dbailey1564/marketsys-pen-routing/docs/three-node-flow-walkthrough.md

# Three-node controller advancement walkthrough

Updated November 4, 2026 for controller 0.6.2 and nodes 0.6.0. The host sends
only a destination for each simulated new head. The controller computes and
applies ACTIVE/LAST/HOLD_OPEN/OFF. The binary application interface and event
identity/replies remain deferred; this is a deliberate bench invocation per head.

| Step | Input/event | Node1 | Node2 | Node3 |
| --- | --- | --- | --- | --- |
| 0 | All OFF | OFF | OFF | OFF |
| 1 | Destination P1 | ACTIVE | OFF | OFF |
| 2 | Destination P2 | LAST | ACTIVE | OFF |
| 3 | Destination P3 | OFF | LAST | ACTIVE |
| 4 | Destination P3 (repeat, HOLD_OPEN) | OFF | OFF | HOLD_OPEN |
| 5 | Destination P2 | OFF | ACTIVE | LAST |
| 6 | Destination P1 | ACTIVE | LAST | OFF |
| 7 | Destination P3 | LAST | OFF | ACTIVE |
| 8 | Destination P2 | OFF | ACTIVE | LAST |
| 9 | Destination P2 (repeat, HOLD_OPEN) | OFF | HOLD_OPEN | OFF |
| 10 | Destination P1 | ACTIVE | LAST | OFF |
| 11 | Destination P1 (repeat, HOLD_OPEN) | HOLD_OPEN | OFF | OFF |
| 12 | Destination P2 | LAST | ACTIVE | OFF |
| 13 | Destination P3 | OFF | LAST | ACTIVE |
| 14 | Finish all OFF | OFF | OFF | OFF |

ACTIVE = solid green; LAST = solid blue; HOLD_OPEN = flashing green. Each row
holds until the user requests `next`. `start` initializes OFF and `stop` performs
explicit new-auction clearing. Manual mode waits for the next command. No light state is
sent by the host on a destination row. Live polls verify all three expected
states after each operation; the user supplies physical color/flashing confirmation.

On Lin, use the UART virtual-environment Python with `scripts/flow_walkthrough.py`
and action `plan`, `start`, `next`, `status` or `stop`. Local test progress is
saved under ignored build/. If delivery/polling fails, the host stops advancing.
Query `FLOW` to resolve an ambiguous result; do not repeat DEST as a retry.
Controller `FLOW=RETRY` resumes paused work, or use explicit new-auction clear.
FULL/FAULT remain outside normal advancement and are not generated by this test.
The prior manual-state walkthrough was prepared but never started; this version
is intended to validate actual controller-owned advancement after upload.

Current rule correction (November 4): HOLD_OPEN clears the previous LAST to OFF and clears its role. Each new head advances that history; blue is not reserved across repeats.

## Automatic demo

On Lin, from the project directory, run:

```sh
python3 scripts/flow_walkthrough.py auto --interval 15 --passes 4
```

Start on an idle bench system. The runner clears the auction at the start of the demo and
at the end of every pass. Each verified
row is held for 15 seconds before issuing the next destination or clear. Four
passes take at least fourteen minutes, plus radio verification. No operator input
is needed between rows. The runner stops if delivery or live polling fails.
After an interruption or failure, use `python3 scripts/flow_walkthrough.py stop`
to request and verify OFF.
