dbailey1564/marketsys-pen-routing/docs/interface-protocol-specification.md

# MarketSys Interface Protocol Specification

Review proposal — October 24, 2026. This document defines the proposed
app-to-controller interface. Firmware does not yet implement this host protocol.
The application assigns a new session ID for each auction and progressive transaction IDs per head within that session. The
CRC procedure below is exact for the current draft; changing frame fields
requires regenerating the frame examples, not changing the CRC algorithm.

## 1. Application boundary

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

## 2. Fixed-size outgoing HEAD_DESTINATION frame

With the proposed session and transaction fields, the outgoing
HEAD_DESTINATION frame is 16 bytes:

| Zero-based offset | COBOL position | Size | Field | Current draft |
| --- | --- | --- | --- | --- |
| 0-1 | 1-2 | 2 | SYNC | AA 55 |
| 2 | 3 | 1 | VERSION | 02 |
| 3 | 4 | 1 | TYPE | 10 = HEAD_DESTINATION |
| 4-7 | 5-8 | 4 | SESSION_ID | New ID for each auction |
| 8-11 | 9-12 | 4 | TRANSACTION_ID | Increasing per-head event number within the auction |
| 12 | 13 | 1 | DESTINATION_NUMBER | Numeric pen number, up to 255 |
| 13 | 14 | 1 | ALPHA_DESIGNATION | Reserved for letter designation |
| 14-15 | 15-16 | 2 | CRC16 | Low byte, then high byte |

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

Session/transaction integers use little-endian byte order in this draft.
If the engineer selects another event-identity structure, update offsets,
frame length and CRC test vectors before implementation. The pair (SESSION_ID, TRANSACTION_ID) identifies one head event. A retry must reuse both IDs and the original destination. A new head receives a new transaction ID even when its destination repeats. An application restart during the same auction must preserve the session and resume its transaction sequence.

## 3. Exact CRC definition

Use CRC-16/CCITT-FALSE, also catalogued as CRC-16/IBM-3740:

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

### 3.1 Exactly which bytes COBOL processes

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

```text
Excluded     Included in CRC, exactly 12 bytes                Excluded
AA 55     | 02 10 78 56 34 12 03 00 00 00 14 00             | CRC CRC
SYNC        VERSION ... ALPHA                                appended later
```

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

### 3.2 Byte-by-byte calculation in COBOL-friendly arithmetic

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

For each covered input byte, from left to right:

1. Obtain its numeric value, 0..255.
2. Multiply that value by 256 and XOR it with the current CRC. This mixes
   the input byte into the HIGH byte of the register.
3. Repeat the following exactly eight times:
   - Save whether the OLD register is at least 32768 (its top bit is 1).
   - Multiply the register by 2 (one-bit left shift).
   - Keep only the remainder after dividing by 65536. This discards carry
     beyond bit 15 and keeps the register in the unsigned 16-bit range.
   - If the saved top bit was 1, XOR the register with 4129 (1021 hex).
4. Keep that result as the starting register for the next input byte.

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

Equivalent pseudocode (XOR here means bitwise exclusive OR):

```text
CRC = 65535
FOR EACH RAW BYTE B:
    CRC = CRC XOR (B * 256)
    REPEAT 8 TIMES:
        OLD_TOP_BIT = (CRC >= 32768)
        CRC = REMAINDER(CRC * 2, 65536)
        IF OLD_TOP_BIT:
            CRC = CRC XOR 4129
RETURN CRC
```

### 3.3 XOR without a vendor-specific COBOL bitwise function

XOR sets a result bit when the two input bits differ:

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

```cobol
xor-16.
    move 0 to ws-xor-result
    move 1 to ws-weight
    perform varying ws-xor-index from 1 by 1 until ws-xor-index > 16
        divide ws-xa by 2 giving ws-xa remainder ws-ra
        divide ws-xb by 2 giving ws-xb remainder ws-rb
        if ws-ra not = ws-rb add ws-weight to ws-xor-result end-if
        multiply 2 by ws-weight
    end-perform.
```

The routine consumes its two operand fields. See the complete compiled
[COBOL reference program](../examples/cobol/crc16_reference.cob) for declarations,
the enclosing eight-bit CRC loop and self-tests. It is a standalone reference
harness, not a drop-in communications application or a callable API definition.

### 3.4 Obtaining and writing raw bytes with ORD and CHAR

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

```cobol
compute ws-byte-value = function ord(ws-data(ws-byte-index:1)) - 1
```

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

The engineer must validate those tests with the actual compiler/runtime and
avoid automatic character-set conversion of the wire buffer. In particular,
the standard check vector uses raw ASCII hex 313233343536373839; on an EBCDIC
platform the ordinary text literal "123456789" need not contain those bytes.
Session IDs, transaction IDs and pen numbers must already be serialized to
the agreed wire bytes BEFORE calculating the CRC.

### 3.5 Appending the CRC to the outgoing COBOL buffer

Split the final numeric CRC explicitly:

```cobol
divide ws-crc by 256 giving ws-high remainder ws-low
compute ws-char-position = ws-low + 1
move function char(ws-char-position) to ws-frame(15:1)
compute ws-char-position = ws-high + 1
move function char(ws-char-position) to ws-frame(16:1)
```

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

## 4. Complete worked frame and intermediate results

Example: session 12345678 hex, transaction 3, pen number 20, no alpha (00):

```text
AA 55 | 02 | 10 | 78 56 34 12 | 03 00 00 00 | 14 | 00 | 35 0B
SYNC    VER  TYPE SESSION       TRANSACTION    PEN  ALPHA CRC
```

CRC input and result after each complete byte:

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

## 5. Receiver check and conformance tests

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

## 6. Remaining interface decisions

See [engineer questions](engineer-questions.md) for persistent event counter
versus session-plus-counter identity. CRC validity does not identify a retry;
event identity does. Reply framing must distinguish controller acceptance
from node-confirmed application/failure and correlate the event. Replies,
resynchronization/timeouts, reset recovery and field allocations remain under
review. AA55 can occur inside a frame: use the known version/type frame size
and CRC, not a second AA55 as an automatic terminator.
