dbailey1564/marketsys-pen-routing/hardware/librepcb/marketsys-node-preview.png

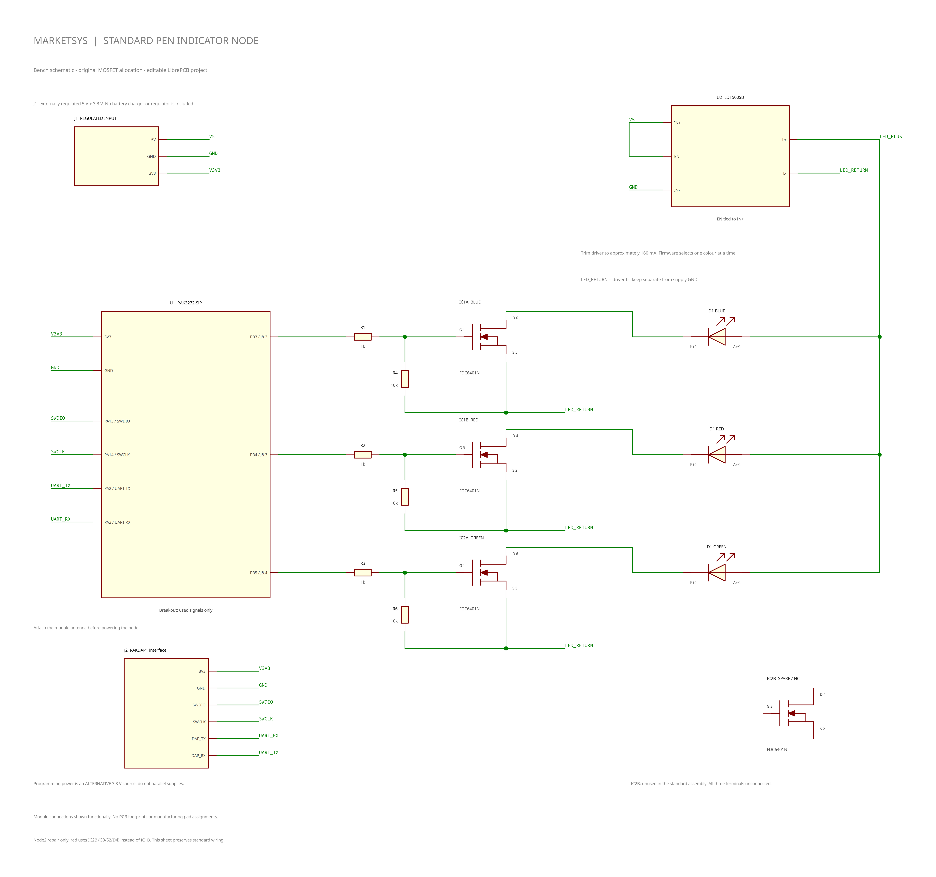
hardware/librepcb/marketsys-node-preview.png
