dbailey1564/marketsys-pen-routing/hardware/librepcb/marketsys-node/connections.csv

component.signal | net
D1.BLUE_A | LED_PLUS
D1.BLUE_K | LED_BLUE_K
D1.GREEN_A | LED_PLUS
D1.GREEN_K | LED_GREEN_K
D1.RED_A | LED_PLUS
D1.RED_K | LED_RED_K
IC1.D1 | LED_BLUE_K
IC1.D2 | LED_RED_K
IC1.G1 | GATE_BLUE
IC1.G2 | GATE_RED
IC1.S1 | LED_RETURN
IC1.S2 | LED_RETURN
IC2.D1 | LED_GREEN_K
IC2.D2
IC2.G1 | GATE_GREEN
IC2.G2
IC2.S1 | LED_RETURN
IC2.S2
J1.3V3 | V3V3
J1.5V | V5
J1.GND | GND
J2.3V3 | V3V3
J2.DAP_RX | UART_TX
J2.DAP_TX | UART_RX
J2.GND | GND
J2.SWCLK | SWCLK
J2.SWDIO | SWDIO
R1.1 | PB3_BLUE
R1.2 | GATE_BLUE
R2.1 | PB4_RED
R2.2 | GATE_RED
R3.1 | PB5_GREEN
R3.2 | GATE_GREEN
R4.1 | LED_RETURN
R4.2 | GATE_BLUE
R5.1 | LED_RETURN
R5.2 | GATE_RED
R6.1 | LED_RETURN
R6.2 | GATE_GREEN
U1.3V3 | V3V3
U1.BLUE | PB3_BLUE
U1.GND | GND
U1.GREEN | PB5_GREEN
U1.RED | PB4_RED
U1.SWCLK | SWCLK
U1.SWDIO | SWDIO
U1.UART_RX | UART_RX
U1.UART_TX | UART_TX
U2.EN | V5
U2.IN+ | V5
U2.IN- | GND
U2.L+ | LED_PLUS
U2.L- | LED_RETURN
