dbailey1564/marketsys-pen-routing/docs/images/node-complete-wiring.png

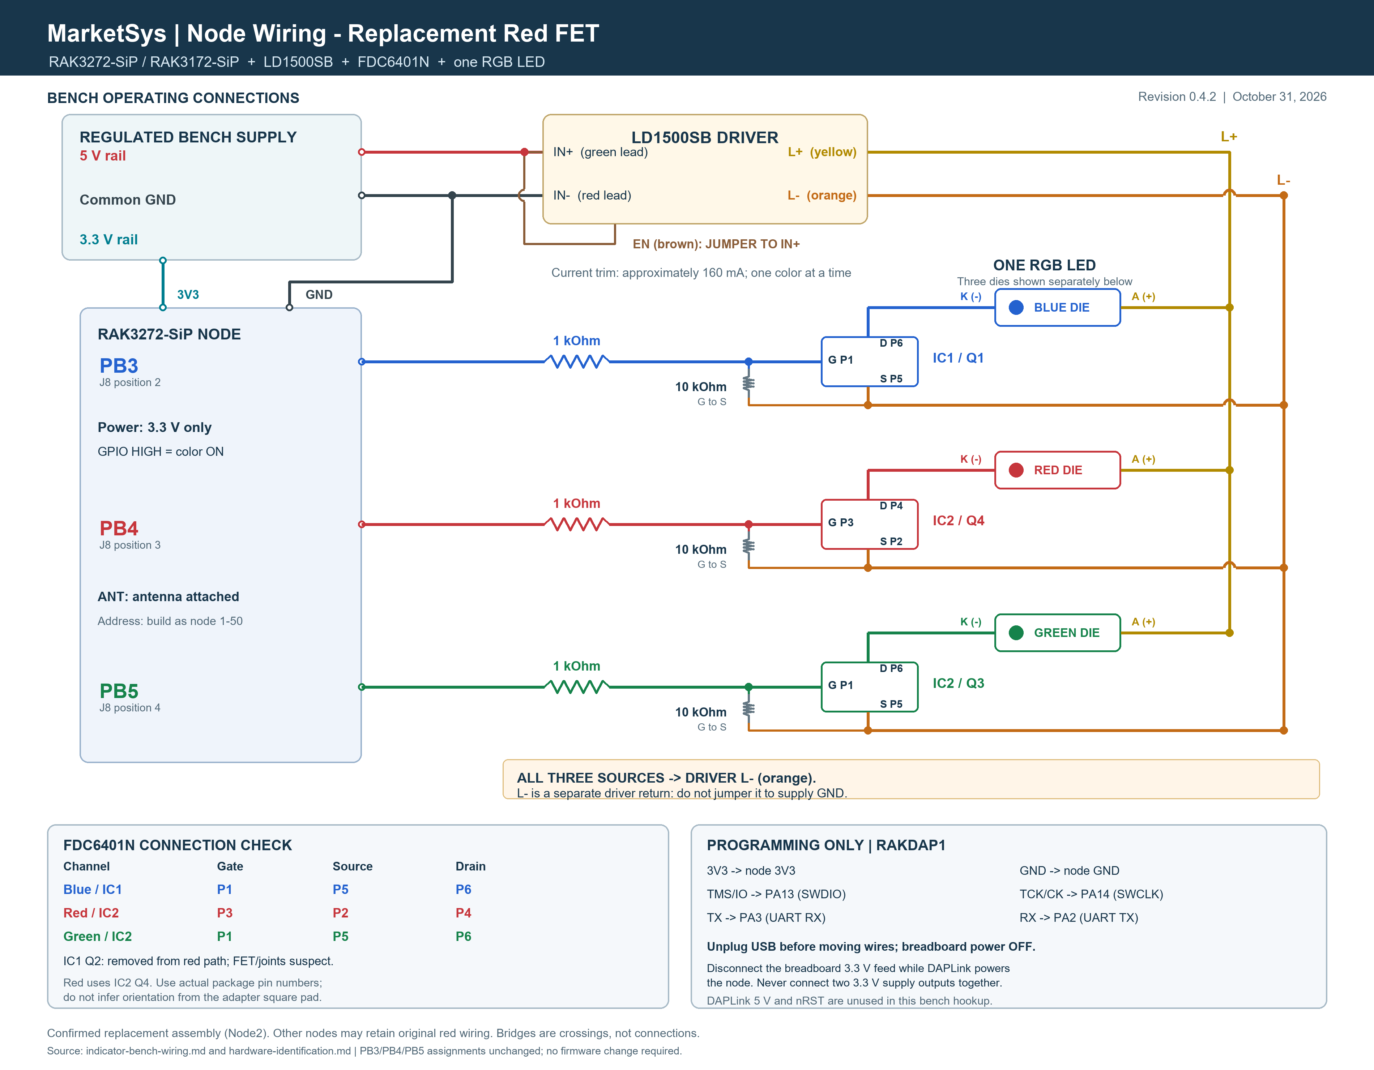
docs/images/node-complete-wiring.png
