dbailey1564/marketsys-pen-routing/(commit log)

2026-10-20 Record verified RAK3272-SiP prototype bring-up
    Pin the RUI3 build environment and add VS Code compile tasks, hardware
    identification and backup helpers, and the minimal serial bring-up sketch.
    Document verified original backups, the first UART upload, application
    readback, unchanged bootloader code, and the limited metadata/settings changes.
    Keep raw flash backups and generated build artifacts outside version control.
2026-10-20 Document solar standby requirements and validate wake timing model
    Record the provisional weekly eight-hour session, solar recharging, sleep
    support, and five-minute activation target. Propose bounded receive windows
    every two minutes with a recovery allowance for one lost whole window.
    Add offline phase/loss analysis and document energy assumptions, unsupported
    failure cases, and the measurements needed before firmware or power selection.
2026-10-21 Validate timer sleep harness and prototype recovery
2026-10-21 Prepare standalone current measurements and energy sensitivity
2026-10-21 Select USB prototype power architecture and document wiring
2026-10-21 Record available demo power banks from photographed labels
2026-10-24 Record corrected indicator wiring and resistor stage
2026-10-24 Record successful Node1 physical LED tests
2026-10-24 Record wireless state application and expiry acknowledgement tests
2026-10-24 Record unavailable-node failure and successful power recovery
2026-10-24 Back up Node1 current iteration and verify revised indicator firmware upload
2026-10-24 Record controller-owned next-active assignment flow direction
2026-10-24 Rename NEXT to LAST while preserving state wire value
2026-10-24 Propose per-head destination event frame for application interface review
2026-10-25 Track engineer decision on session versus persistent event identity
2026-10-25 Document COBOL CRC calculation and fixed-size host frame
2026-10-25 Record Node1 UART diagnosis before pending upload
2026-10-25 Complete verified four-board firmware 0.4.2 deployment
2026-10-25 Add current pen indicator states and intended flow PDF
2026-10-28 Add complete node wiring PNG and reproducible drawing source
2026-10-30 Record EN tie-high wiring and loose-connection indication retest
2026-10-31 Document Node2 replacement red FET wiring
2026-10-31 Record controller routing retention across power loss
2026-10-31 Record ratified two-stage application replies
2026-10-31 Verify Node1 restores saved indication after power cycle
2026-10-31 Verify Node2 power-cycle restoration and OFF cleanup
2026-10-31 Prepare manually stepped three-node flow walkthrough
2026-11-04 Verify controller 0.6.1 deployment and initialize flow walkthrough
2026-11-04 Record captured Node1 startup and shared-power question
2026-11-04 Record inconclusive Node1 UART attempt and restored controller link
2026-11-04 Record complete Node1 receive-only startup and resume flow testing
2026-11-06 Add editable LibrePCB standard node schematic
2026-11-11 Report node supply voltage in live LoRa polls
